Staudi14/tube-amplifier/Measurements/Tempreture spreading/VT_0004T.png

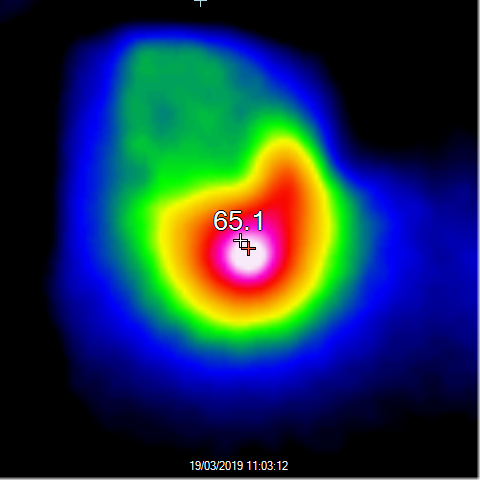
Measurements/Tempreture spreading/VT_0004T.png
