Staudi14/tube-amplifier/README.md

# tube-amplifier
2 - channel tube amplifier
