Staudi14/tube-amplifier/Präsentation/Staudenmayer_Schrefl_ProjektRöhrenverstärker.pptx

## Röhrenverstärker

Präsentation von Christian Schrefl und Patrik Staudenmayer

Christian Schrefl, Patrik Staudenmayer

## Inhaltsverzeichnis

- Projektbeschreibung
- Netzteil
  - Blockschaltbild
  - Transformator Grenzdaten
  - Tiefpass
  - Spannungsanpassung
  - Schaltplan des Netzteils
- Verstärker
  - Röhren kurz erklärt
  - Endstufe
  - Gesamtschaltung
  - Testaufbau
  - Messung
- Gehäuse

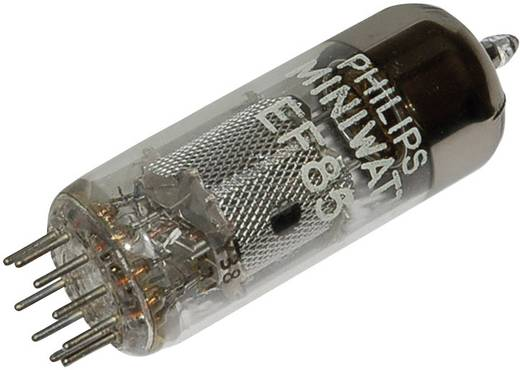
[picture p21: figure]

## Projektbeschreibung : Individuelle Themenstellungen

Patrik Staudenmayer | Adaption der üblichen Schaltkonzepte eines Netzteiles für Röhren, sowie Auswahl und Bestellung der Bauteile, Leiterplattenentwicklung für das Netzteils, sowie Berechnung der Ausgangsüberträger.
Christian Schrefl | Adaption der üblichen Schaltkonzepte der verstärkenden Elemente, sowie Auswahl und Bestellung der Bauteile, Aufbau der verstärkenden Elemente.

## Projektbeschreibung : Geplantes Ergebnis

Patrik Staudenmayer | Das Netzteil soll stabil die Versorgungsspannungen liefern.
Christian Schrefl | Die Verstärkenden Elemente sollen stabil ein Eingangssignal mit 6W ausgeben.

## Projektbeschreibung : Meilensteine

- 27.11.2018 Entwicklung des Schaltungskonzepts abgeschlossen, benötigte Bauteile bestellt
- 15.01.2019 Prototyp der Verstärkerschaltung (1 Kanal) fertiggestellt
- 26.02.2019 Leiterplattenentwicklung abgeschlossen
- 30.04.2019 Finale Version des Netzteils und eines Kanales
- 28.05.2019 Gesamttests abgeschlossen

## Netzteil : Blockschaltbild


280V DC

280V DC

## Netzteil : Transformator Grenzdaten

| Primärseite | Sekundärseite
Spannungen | 230 V_(RMS) | 250 V_(peak)
| | 6,3 V_(RMS)
Ströme | (104mA∗250V+1,6A∗6,3V)/(230V)=0,157A an der 230 V_(RMS) Wicklung | 2∗(50 mA+2mA)=104mA an der 250 V_(peak) Wicklung
| | 2^1 ∗(0,76A^2 +0,3A^3 )=1,6A an der 6,3 V_(RMS) Wicklung

[1] Es wird der doppelte Strom benötigt, da zwei Röhren für einen Stereoverstärker benötigt werden.
[2] Ströme für die Endstufenröhre EL84
[3] Ströme für die Vorverstärkerröhre 12AX7

## Netzteil : Transformator Grenzdaten

- Verwendeter Trafo: TRA400 von die-wuesten.de
- 200VA Trafo

Primärseite | Sekundärseite
100V | 2 * 270 V_(eff) 200mA
127V | 2 * 5 0V_(eff) 200mA
230V | 5 V_(eff) 3,5A
| 6,3V 2A
| 6,3V 7A

## Netzteil : Tiefpass

- Grenzfrequenz f_g <100Hz , da:


## Netzteil : Tiefpass

## Netzteil : Tiefpass

## Netzteil : Spannungsanpassung

- Trafo transformiert Eingangsspannung auf eine zu hohe Ausgangsspannung -> Spannungsteiler
R_1 =(70V)/((280V)/(2,5k))=625Ω
- Realisierung von R_1 :

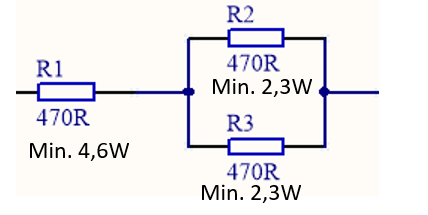
[picture p22: figure]
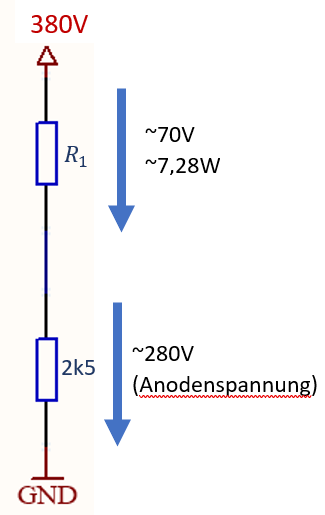
[picture p23: figure]

## Netzteil : Schaltplan

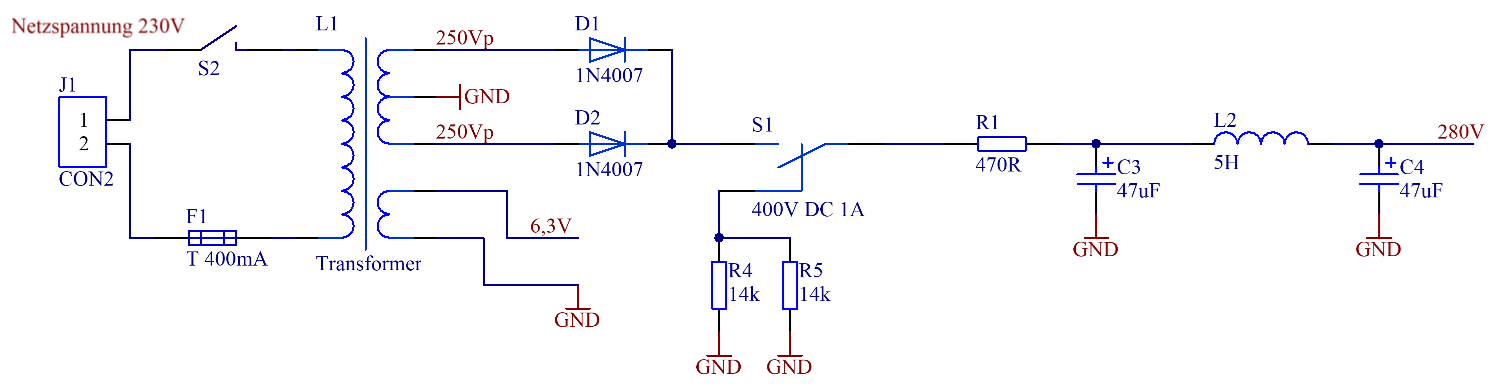
[picture p24: figure]

## Verstärker : Röhren kurz erklärt

- Was sind Elektronenröhren:

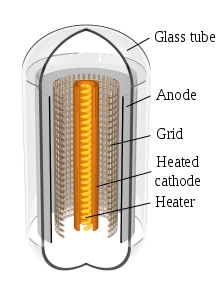
[picture p25: figure]
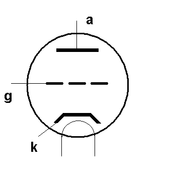
[picture p26: figure]

## Verstärker: Endstufe

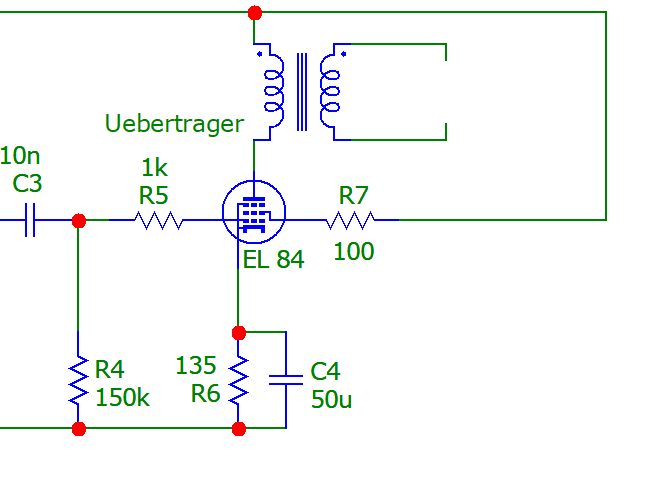
[picture p27: figure]

5,2k Ohm

8 Ohm Ausgang

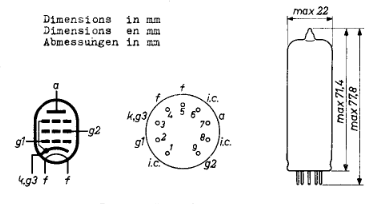
[picture p28: figure]

EL 84 Pin-out

+

## Verstärker: Gesamtschaltung

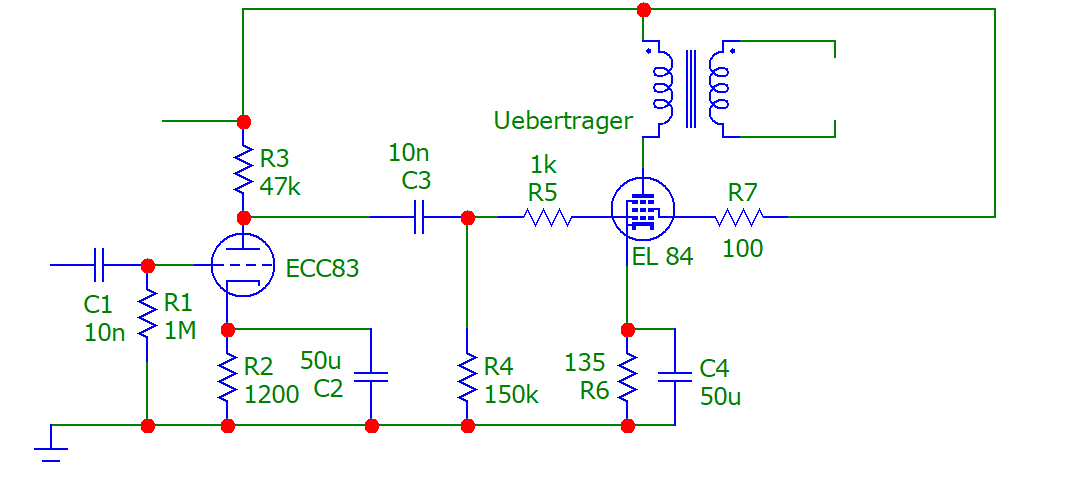
[picture p29: figure]

280V DC in

Out

Signal in

+

+

## Verstärker: Testaufbau

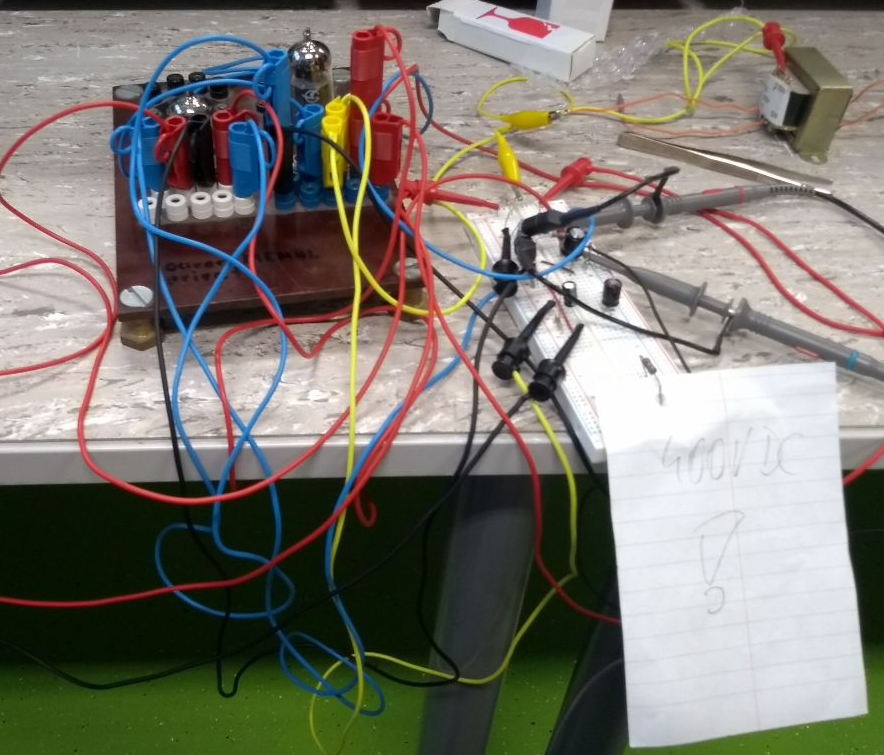
[picture p30: figure]
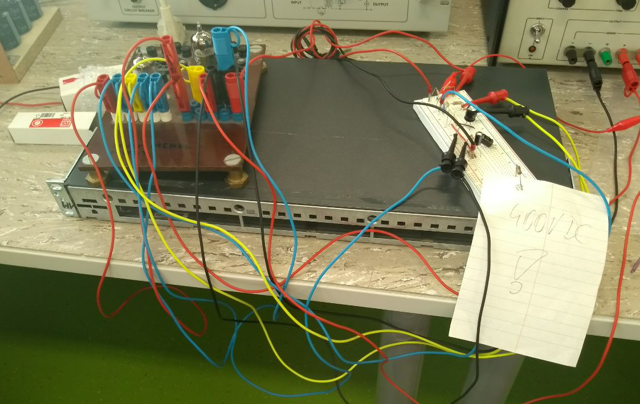
[picture p31: figure]

## Slide 18

Verstärker: Messungen

Bode Diagram linker Kanal

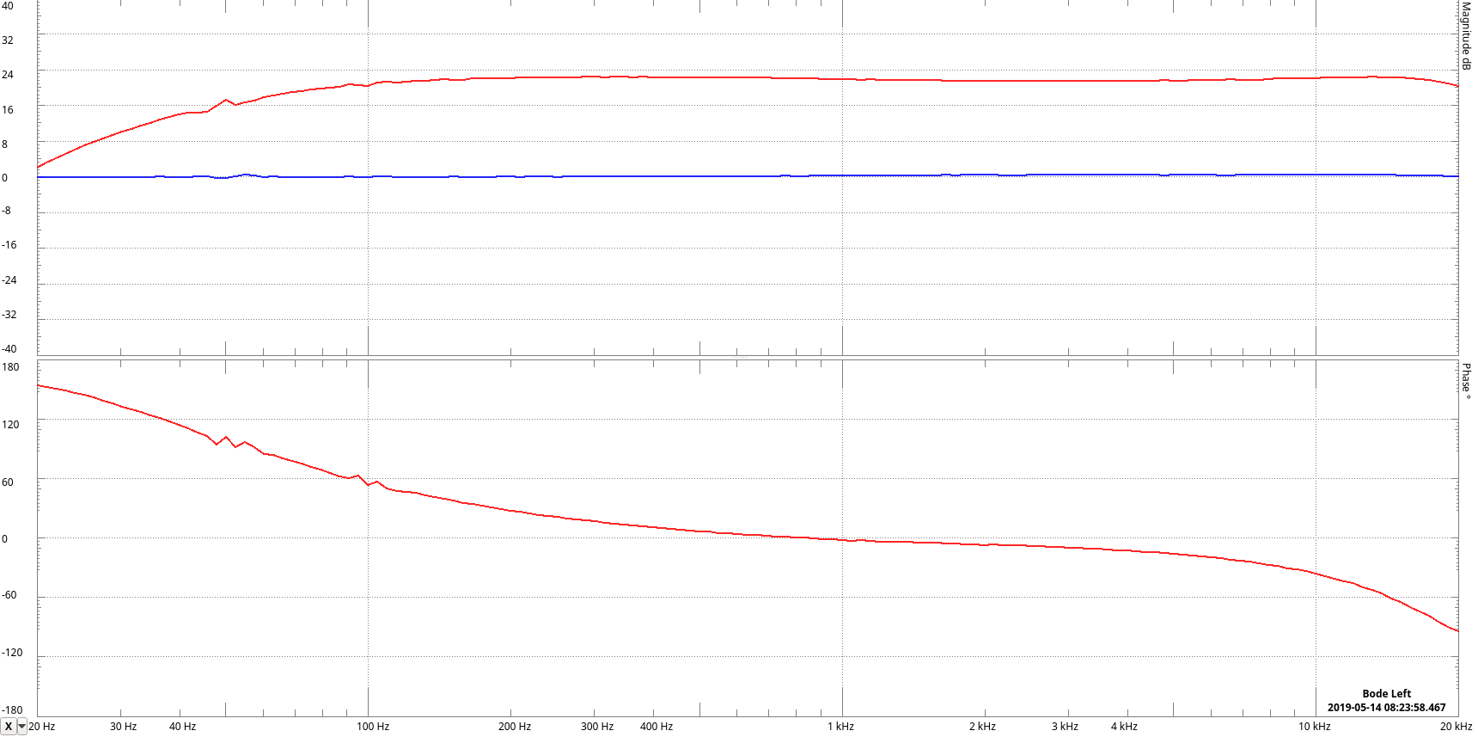
[picture p32: figure]

Christian Schrefl, Patrik Staudenmayer

## Slide 19

Verstärker: Messungen

Bode Diagram rechter Kanal

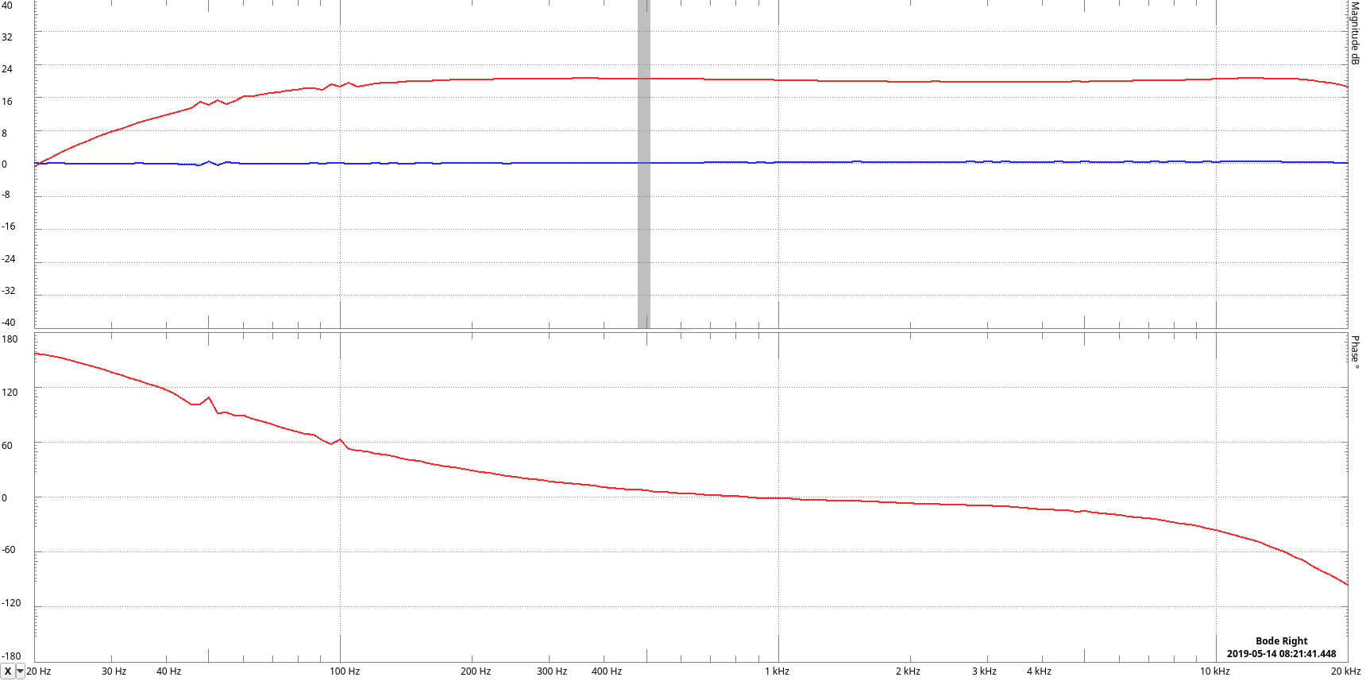
[picture p33: figure]

Christian Schrefl, Patrik Staudenmayer

## Gehäuse

- Alle Spulen zueinander verdreht
- Möglichst viel Abstand zwischen Verstärkenden Elementen und Netzteil
