Staudi14/tube-amplifier/Ideensammlung.docx

5 Kanal Röhrenverstärker

5 Kanal Röhrenverstärker für 5.0 Sound Anlage

Ziele:

- 5 x 6W
- Netzteil für Anodenspannung
- Netzteil für Übrige Beschaltung ?
- Ausgangswiderstand 4-8Ω
- Gehäuse
