Staudi14/tube-amplifier/Bestelliste/Ausgangsübertrager.PNG

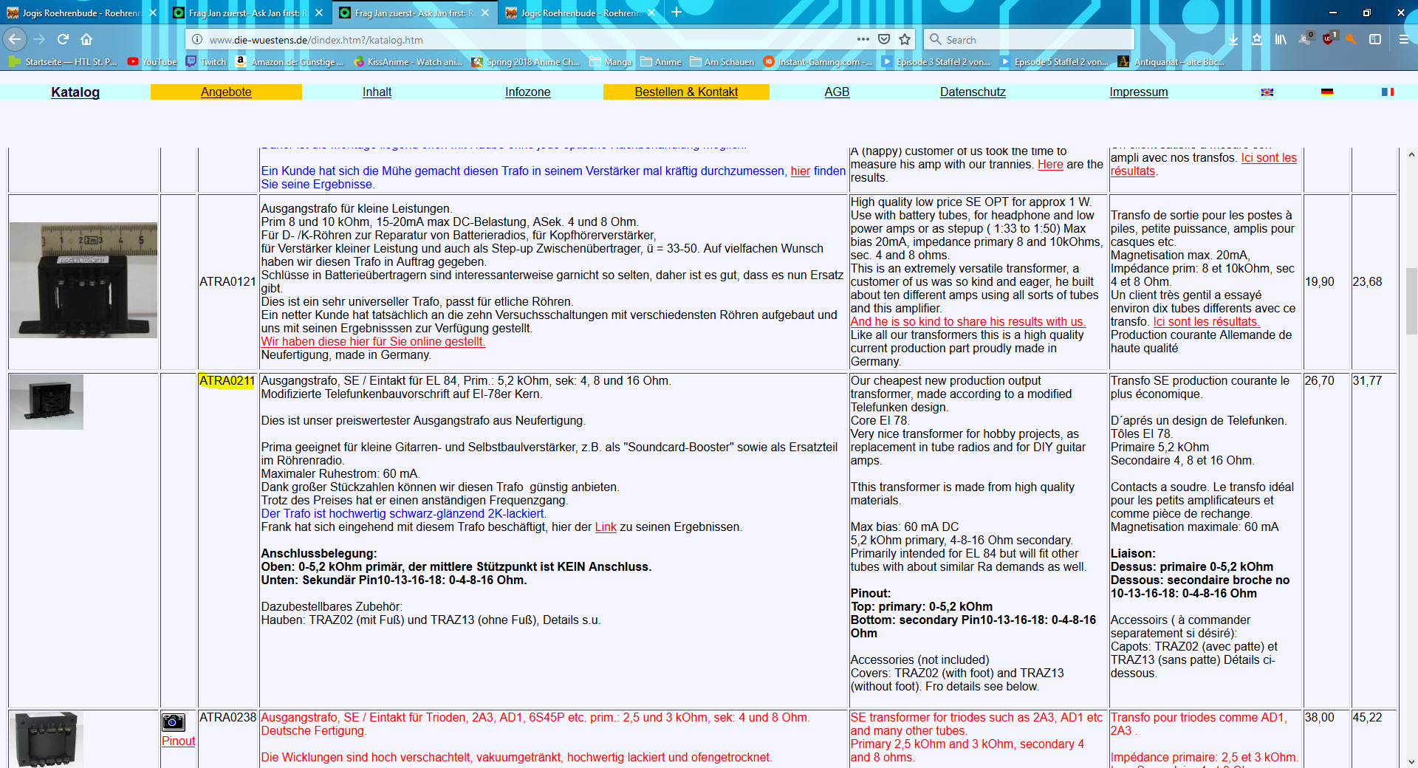
Bestelliste/Ausgangsübertrager.PNG
