Staudi14/tube-amplifier/Bestelliste/Netzdrossel.PNG

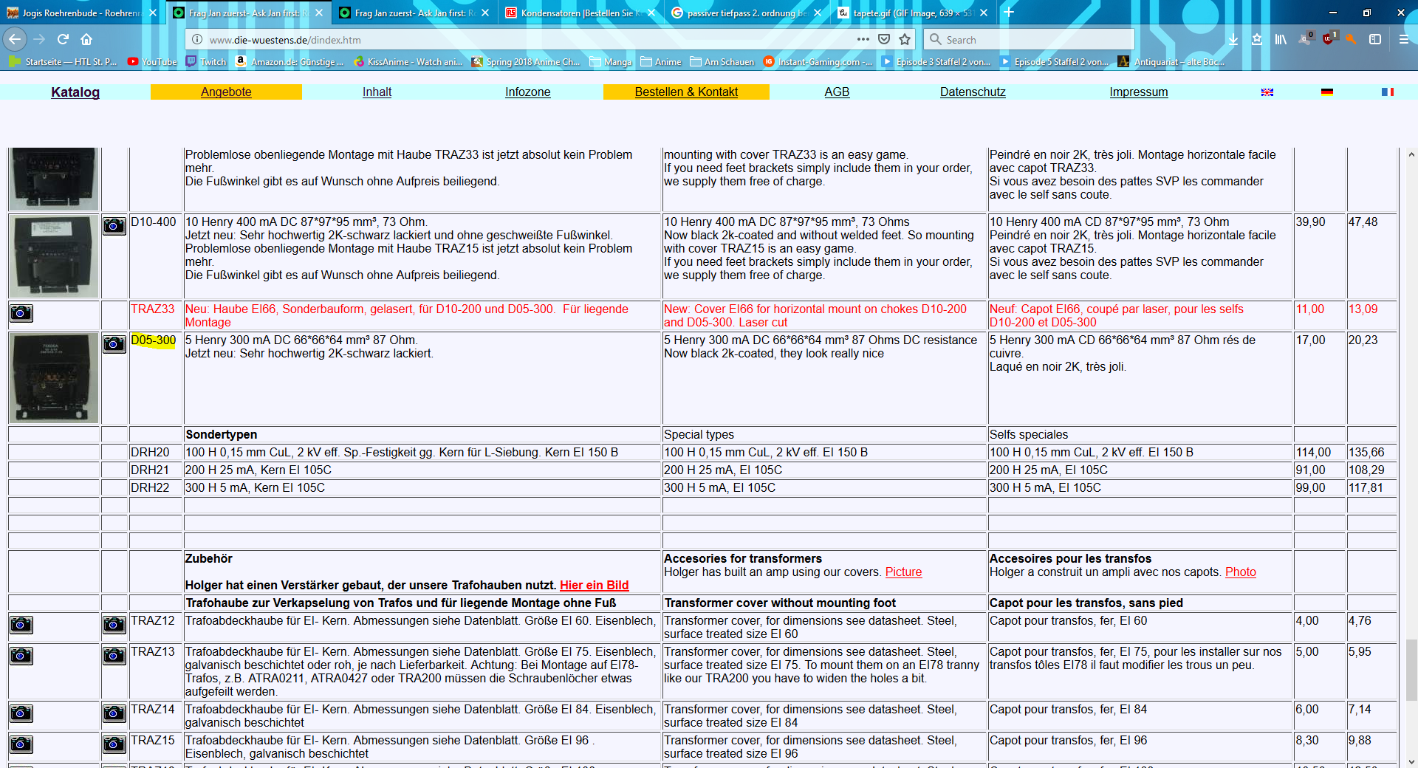
Bestelliste/Netzdrossel.PNG
