Staudi14/tube-amplifier/Bestelliste/Trafo.PNG

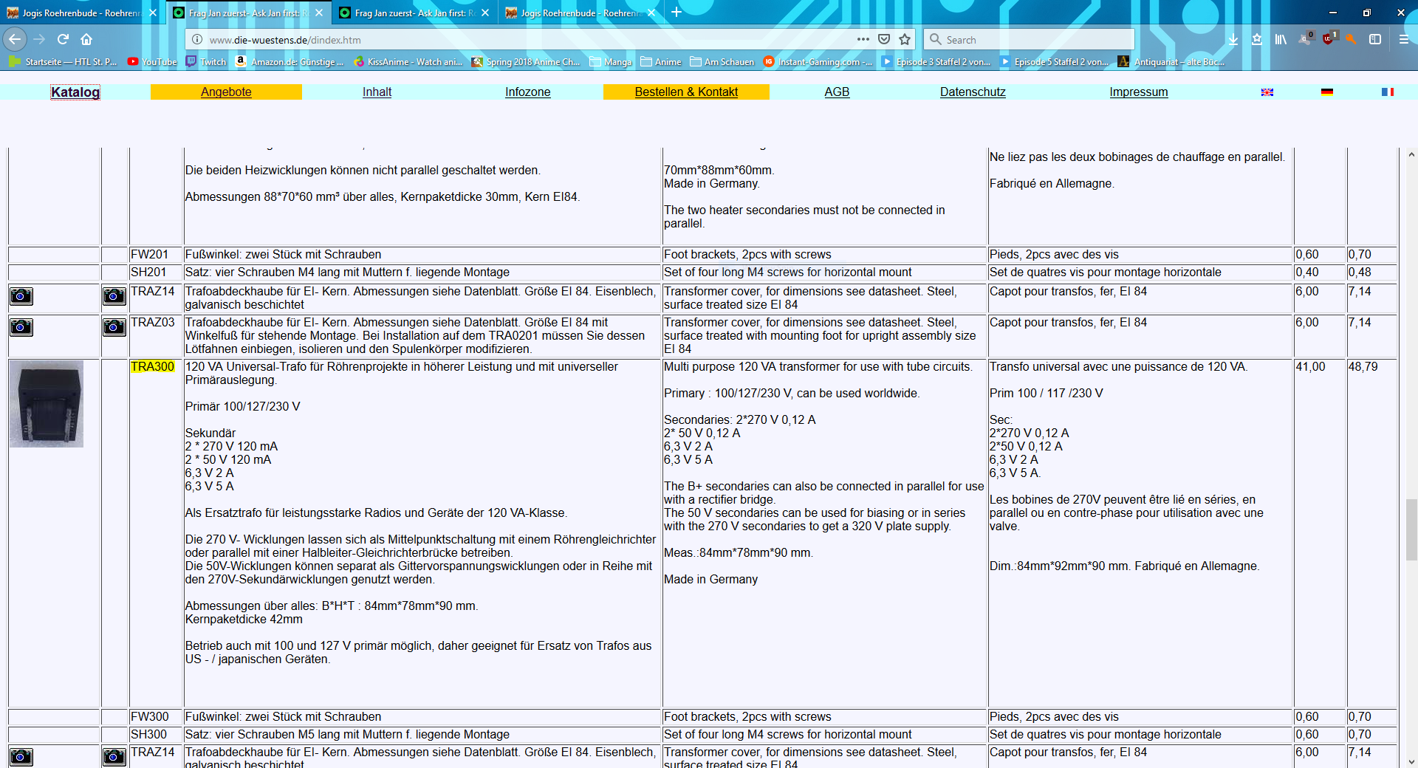
Bestelliste/Trafo.PNG
