Staudi14/tube-amplifier/Gehaeuse/Gehaeuse_Deckel-1.png

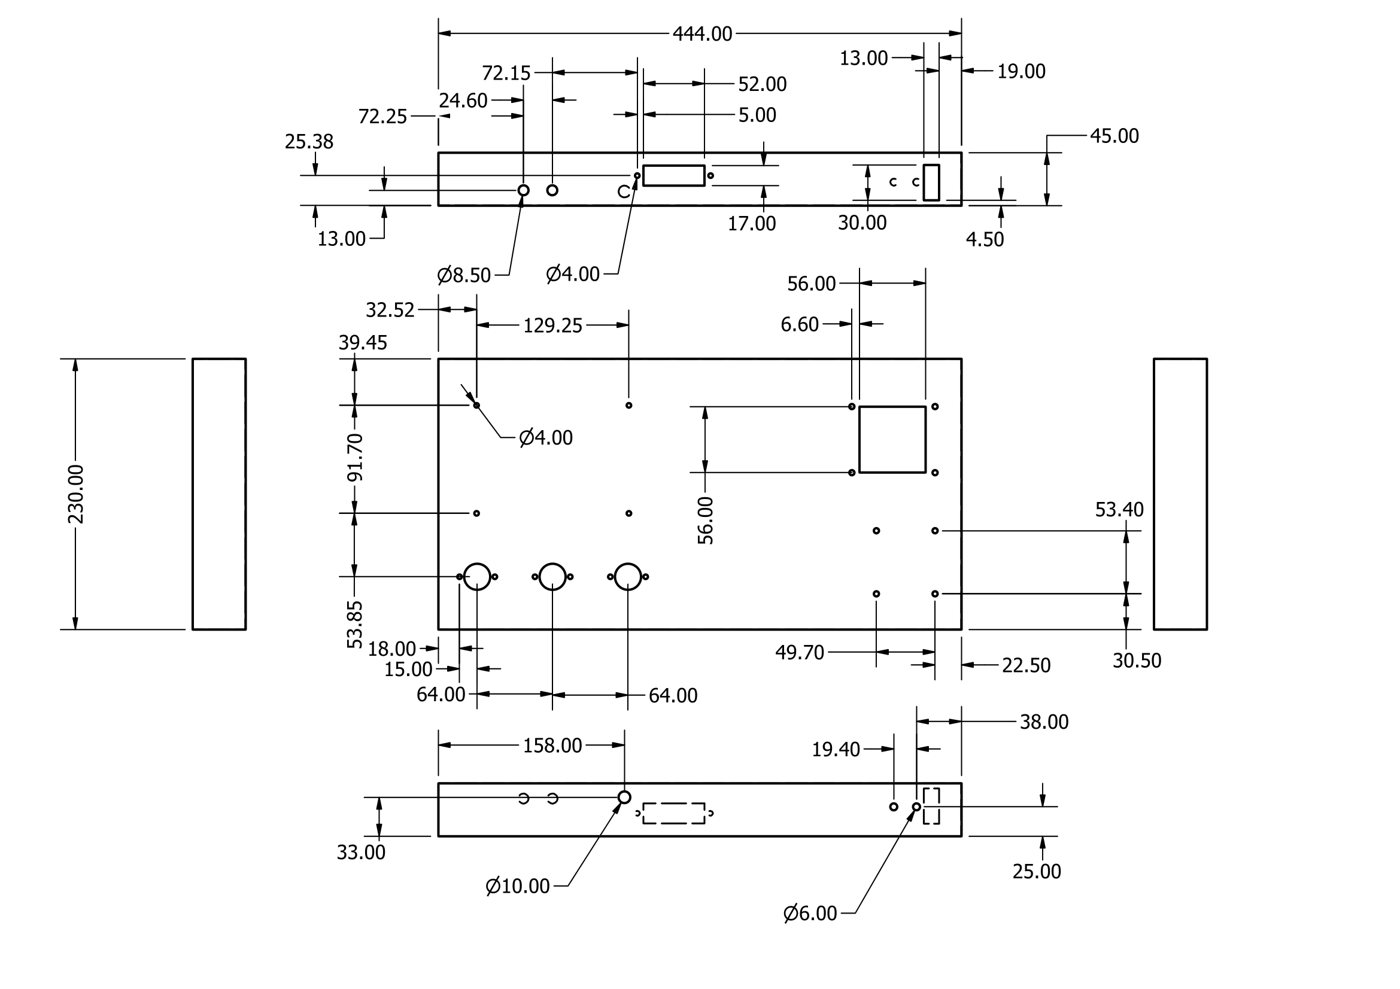
Gehaeuse/Gehaeuse_Deckel-1.png
