Staudi14/tube-amplifier/(list of files, cad)

Other CAD files:
Gehaeuse/Gehaeuse_Deckel.dwg
Gehaeuse/OldVersions/Gehaeuse_Deckel.0000.dwg
Gehaeuse/OldVersions/Gehaeuse_Deckel.0001.dwg
Gehaeuse/Gehaeuse_Deckel.ipt
Gehaeuse/OldVersions/Gehaeuse_Deckel.0011.ipt
