Staudi14/tube-amplifier/Measurements/Bode_Full.csv

Frequency (Hz) | Channel 2 Magnitude (dB) | Channel 2 Phase (°)
20 | -27.609554809618938 | 15.929451371303644
20.185243819740947 | -27.404829168923243 | 15.459493041847756
20.372203403119507 | -27.117453394221322 | 15.162586536047026
20.560894641866195 | -27.095344961004404 | 16.008301263267562
20.751333574903718 | -26.741915419935061 | 15.523338533334313
20.943536389710406 | -26.530944036880072 | 15.8468582360045
21.13751942369608 | -26.53119728128604 | 14.757073651138802
21.333299165590773 | -26.230332509274366 | 14.212280454128788
21.530892256846318 | -26.198858114044754 | 14.278061058173554
21.730315493050767 | -25.934395849334283 | 14.10321601754114
21.931585825356198 | -25.671464961845523 | 13.704491366940626
22.13472036191947 | -25.470076076075088 | 13.354230234248277
22.339736369356451 | -25.237804859199329 | 13.260474473127189
22.546651274209744 | -25.266508951407864 | 13.153983774522038
22.755482664429827 | -24.973872454523267 | 12.253375745905737
22.966248290870222 | -24.843293504313326 | 12.241395769052122
23.17896606879621 | -24.609501812396253 | 11.160383722100294
23.393654079407693 | -24.421164408995818 | 12.132719261717583
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
