Staudi14/tube-amplifier/Measurements/Inputamplifier.csv

x-axis | 1 | 2
second | Volt | Volt
-2.500000E-03 | +28.643213E-03 | -502.512515E-03
-2.497500E-03 | +34.673364E-03 | -582.914524E-03
-2.495000E-03 | +32.663314E-03 | -582.914524E-03
-2.492500E-03 | +28.643213E-03 | -502.512515E-03
-2.490000E-03 | +28.643213E-03 | -502.512515E-03
-2.487500E-03 | +28.643213E-03 | -422.110505E-03
-2.485000E-03 | +32.663314E-03 | -502.512515E-03
-2.482500E-03 | +28.643213E-03 | -422.110505E-03
-2.480000E-03 | +28.643213E-03 | -422.110505E-03
-2.477500E-03 | +28.643213E-03 | -341.708496E-03
-2.475000E-03 | +26.633163E-03 | -341.708496E-03
-2.472500E-03 | +26.633163E-03 | -341.708496E-03
-2.470000E-03 | +22.613063E-03 | -261.306487E-03
-2.467500E-03 | +22.613063E-03 | -261.306487E-03
-2.465000E-03 | +24.623113E-03 | -261.306487E-03
-2.462500E-03 | +22.613063E-03 | -180.904478E-03
-2.460000E-03 | +22.613063E-03 | -180.904478E-03
-2.457500E-03 | +18.592962E-03 | -100.502469E-03
-2.455000E-03 | +20.603012E-03 | -180.904478E-03
-2.452500E-03 | +20.603012E-03 | -100.502469E-03
-2.450000E-03 | +18.592962E-03 | -20.100459E-03
-2.447500E-03 | +14.572862E-03 | -20.100459E-03
-2.445000E-03 | +14.572862E-03 | +60.301550E-03
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
