Staudi14/tube-amplifier/Measurements/Left output.csv

#Digilent WaveForms Network Analyzer - Bode
#Device Name: Discovery2
#Serial Number: SN:210321A68A6E
#Date Time: 2019-03-26 10:03:55.723
#Start: 100 Hz
#Stop: 30000 Hz
#Steps: 151
#Wavegen: Wavegen1
#Amplification: 1 X
#Settle: 10 ms
#MinPeriods: 16
#Channel: Channel 2
#Range: 5.44304 V
#Offset: -1.08332e-05 V
#Relative: yes
#Wavegen Channel 1: Enabled
#Mode: Simple
#Type: Sine
#Frequency: 5 kHz
#Amplitude: 50 mV
#Offset: 0 V
#Symmetry: 50 %
#Phase: 0 °
#Wavegen Channel 2: Enabled
#Mode: Simple
#Type: Sine
#Frequency: 5 kHz
#Amplitude: 50 mV
#Offset: 0 V
#Symmetry: 50 %
#Phase: 0 °
Frequency (Hz) | Channel 2 Magnitude (dB) | Channel 2 Phase (°)
100 | 37.483 | 47.1673
103.876 | 37.3478 | 46.5331
107.902 | 37.4618 | 45.2117
112.084 | 37.6913 | 42.6198
116.428 | 37.7417 | 42.4512
120.94 | 37.8351 | 40.7507
125.628 | 37.9178 | 38.9991
130.497 | 38.0102 | 37.8028
135.554 | 38.0167 | 36.5881
140.808 | 38.1295 | 35.5902
146.265 | 38.2059 | 34.2108
151.934 | 38.228 | 33.1795
157.823 | 38.2462 | 31.596
163.94 | 38.3119 | 30.9734
170.293 | 38.3425 | 29.5195
176.894 | 38.4077 | 28.3815
183.75 | 38.4562 | 27.5559
190.871 | 38.49 | 26.62
198.269 | 38.5381 | 25.6133
205.953 | 38.5622 | 24.6646
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
