Staudi14/tube-amplifier/Measurements/Preamp.csv

#Digilent WaveForms Oscilloscope Acquisition
#Device Name: Discovery2
#Serial Number: SN:210321A68A76
#Date Time: 2019-03-19 09:03:45.091
#Sample rate: 4e+06Hz
#Samples: 8192
#Trigger: Source: Channel 2 Type: Edge Condition: Rising Level: 0 V Hyst.: Auto HoldOff: 0 s
#Channel 1: Range: 100 mV/div Offset: 300 mV
#Channel 2: Range: 2 V/div Offset: -4 V
#Wavegen Channel 1: Running
#Mode: Simple
#Type: Sine
#Frequency: 1 kHz
#Amplitude: 100 mV
#Offset: 0 V
#Symmetry: 50 %
#Phase: 0 °
Time (s) | Channel 1 (V) | Channel 2 (V)
-0.00102375 | 0.0171074 | -0.817156
-0.0010235 | 0.013811 | -0.803896
-0.00102325 | 0.013811 | -0.797266
-0.001023 | 0.013811 | -0.784006
-0.00102275 | 0.0171074 | -0.777376
-0.0010225 | 0.0171074 | -0.767432
-0.00102225 | 0.013811 | -0.760802
-0.001022 | 0.013811 | -0.757487
-0.00102175 | 0.013811 | -0.750857
-0.0010215 | 0.00721821 | -0.744227
-0.00102125 | 0.0105146 | -0.730967
-0.001021 | 0.0105146 | -0.714393
-0.00102075 | 0.0105146 | -0.697818
-0.0010205 | 0.0105146 | -0.694503
-0.00102025 | 0.00721821 | -0.681243
-0.00102 | 0.0105146 | -0.674613
-0.00101975 | 0.00721821 | -0.664669
-0.0010195 | 0.013811 | -0.661354
-0.00101925 | 0.013811 | -0.654724
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
