Staudi14/tube-amplifier/Measurements/Preamp_bode.csv

#Digilent WaveForms Network Analyzer - Bode
#Device Name: Discovery2
#Serial Number: SN:210321A68A76
#Date Time: 2019-03-19 09:13:46.624
#Start: 10 Hz
#Stop: 200000 Hz
#Steps: 151
#Wavegen: Wavegen1
#Amplification: 1 X
#Settle: 10 ms
#MinPeriods: 16
#Channel: Channel 1
#Range: 54.0084 V
#Offset: 0.00307853 V
#Relative: no
#Channel: Channel 2
#Range: 54.3119 V
#Offset: 0.00315965 V
#Relative: yes
Frequency (Hz) | Channel 1 Magnitude (dB) | Channel 2 Magnitude (dB) | Channel 2 Phase (°)
10 | 0.0170059 | 27.0257 | -100.161
10.6825 | 0.0336365 | 27.5097 | -102.506
11.4116 | 0.0210581 | 28.0086 | -104.803
12.1905 | 0.027551 | 28.4716 | -107.159
13.0225 | 0.0191447 | 28.9326 | -109.424
13.9113 | 0.027777 | 29.3615 | -111.78
14.8608 | 0.00175117 | 29.8062 | -114.201
15.875 | 0.022565 | 30.1869 | -116.514
16.9585 | 0.0217195 | 30.57 | -118.742
18.116 | 0.017376 | 30.9362 | -121.21
19.3524 | 0.0248722 | 31.2742 | -123.48
20.6733 | 0.0271715 | 31.5961 | -125.809
22.0842 | 0.00741973 | 31.9202 | -128.123
23.5915 | 0.0169384 | 32.1968 | -130.398
25.2017 | 0.0247875 | 32.4562 | -132.648
26.9217 | 0.0140341 | 32.7114 | -134.826
28.7592 | 0.0172974 | 32.9361 | -137.005
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
