Staudi14/tube-amplifier/Measurements/Bode_Full.png

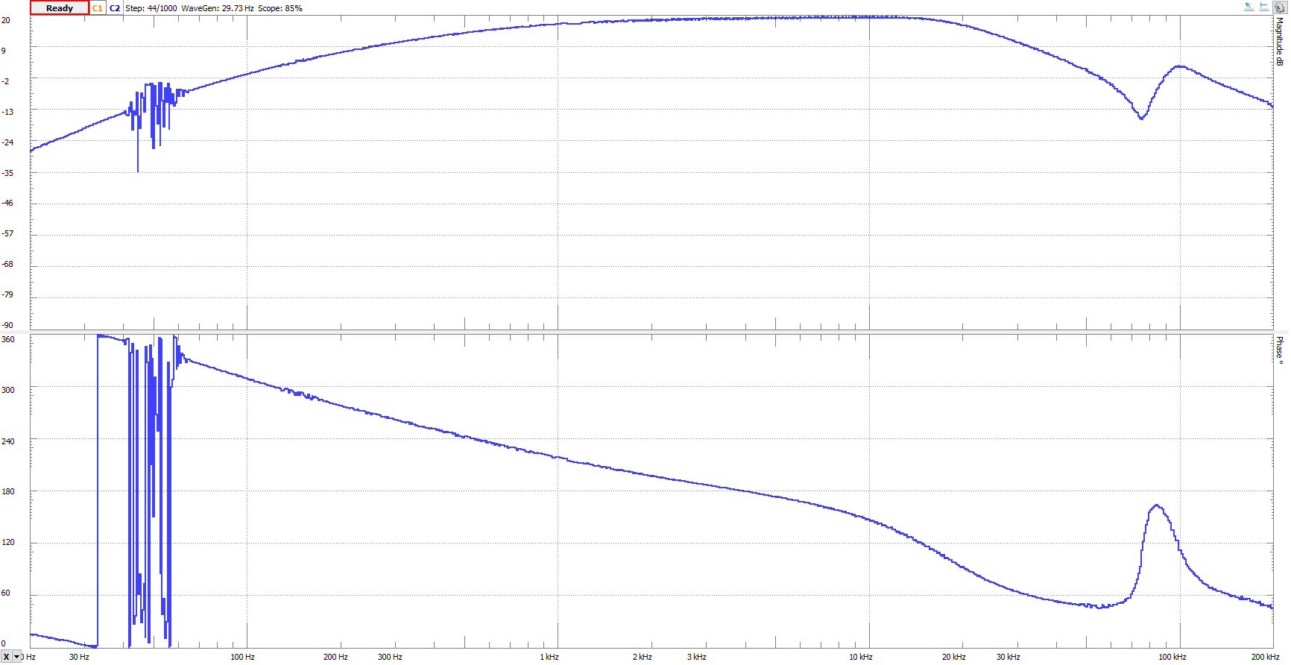
Measurements/Bode_Full.png
