Staudi14/tube-amplifier/Measurements/bode_left _full.png

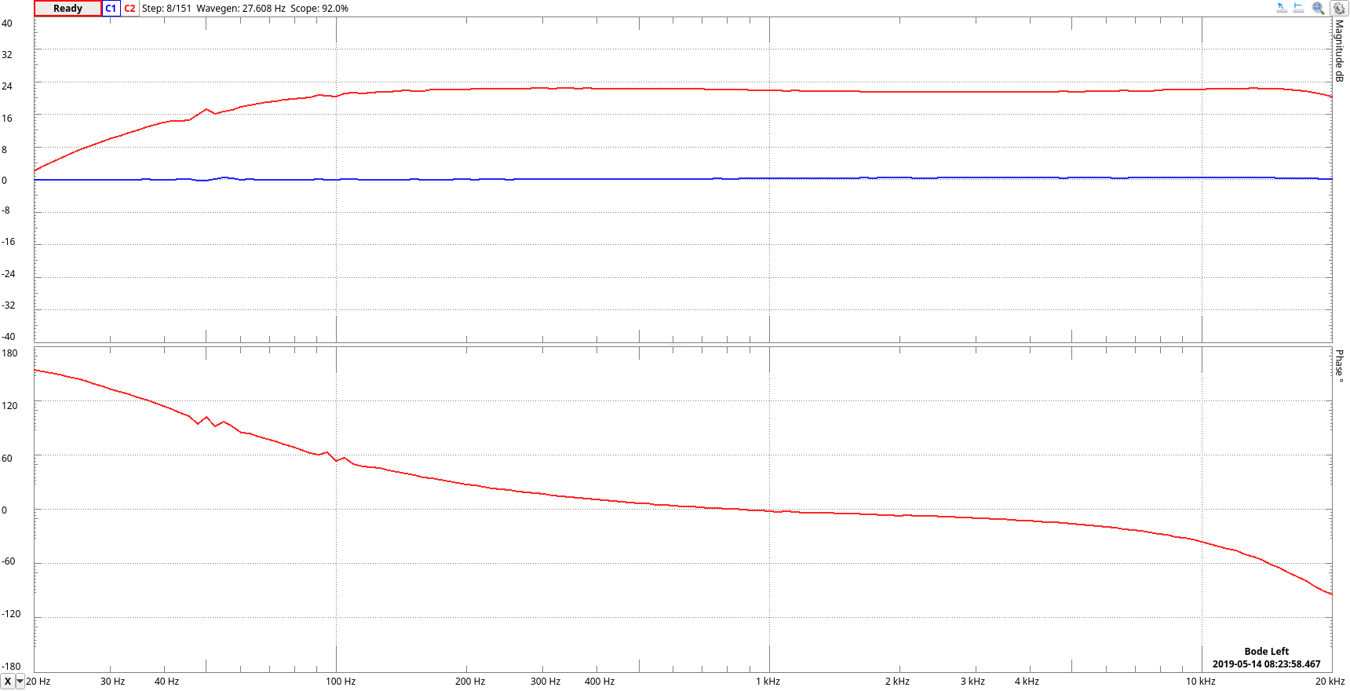
Measurements/bode_left _full.png
