Staudi14/tube-amplifier/Measurements/bode_right _full.png

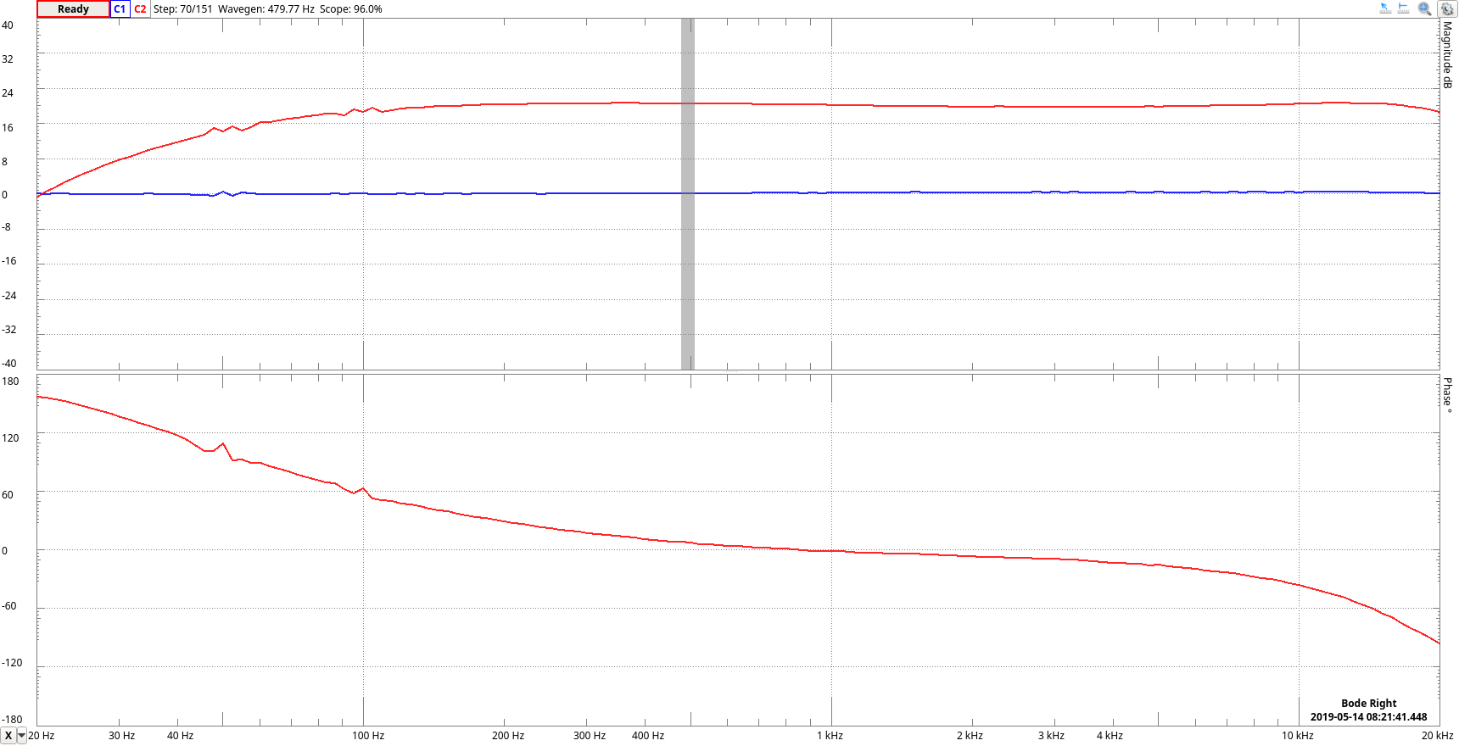
Measurements/bode_right _full.png
