Staudi14/tube-amplifier/Measurements/FallDelay.png

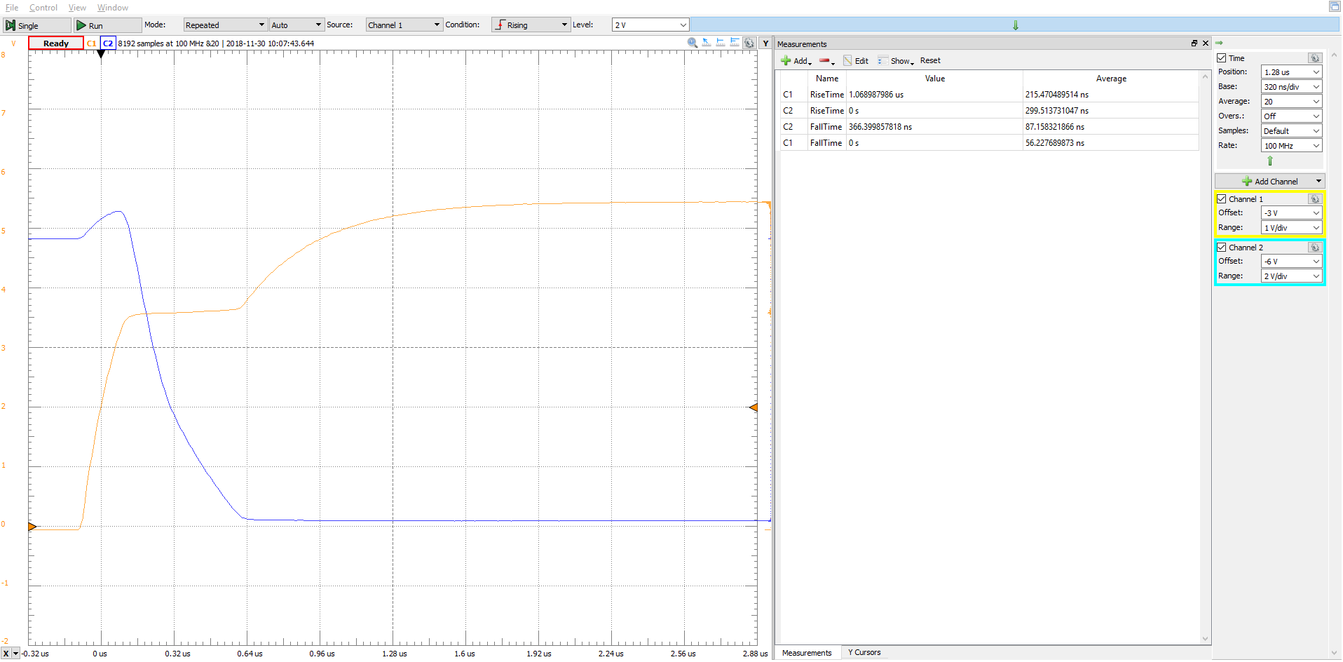
Measurements/FallDelay.png
