Staudi14/tube-amplifier/Measurements/Inputamplifier 50Hz modulation.png

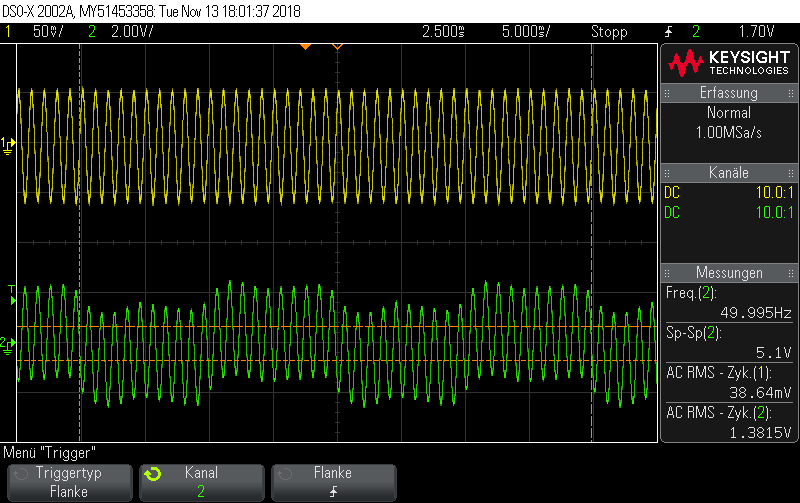
Measurements/Inputamplifier 50Hz modulation.png
