Staudi14/tube-amplifier/Measurements/Inputamplifier.png

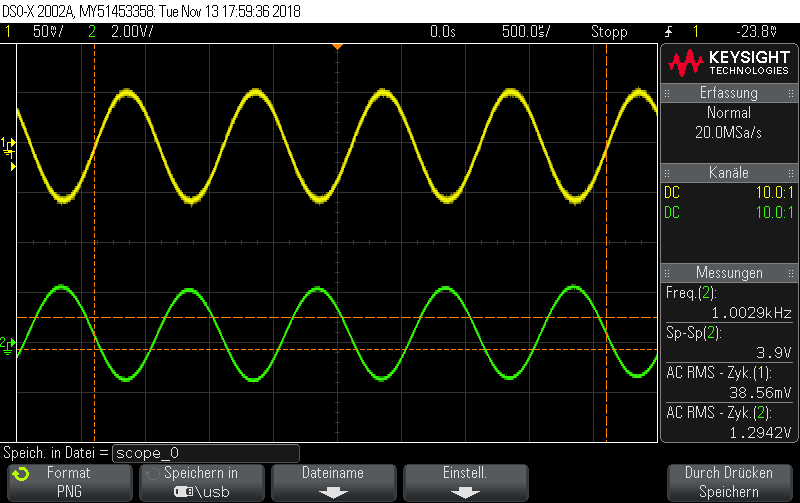
Measurements/Inputamplifier.png
