Staudi14/tube-amplifier/Measurements/Left output.png

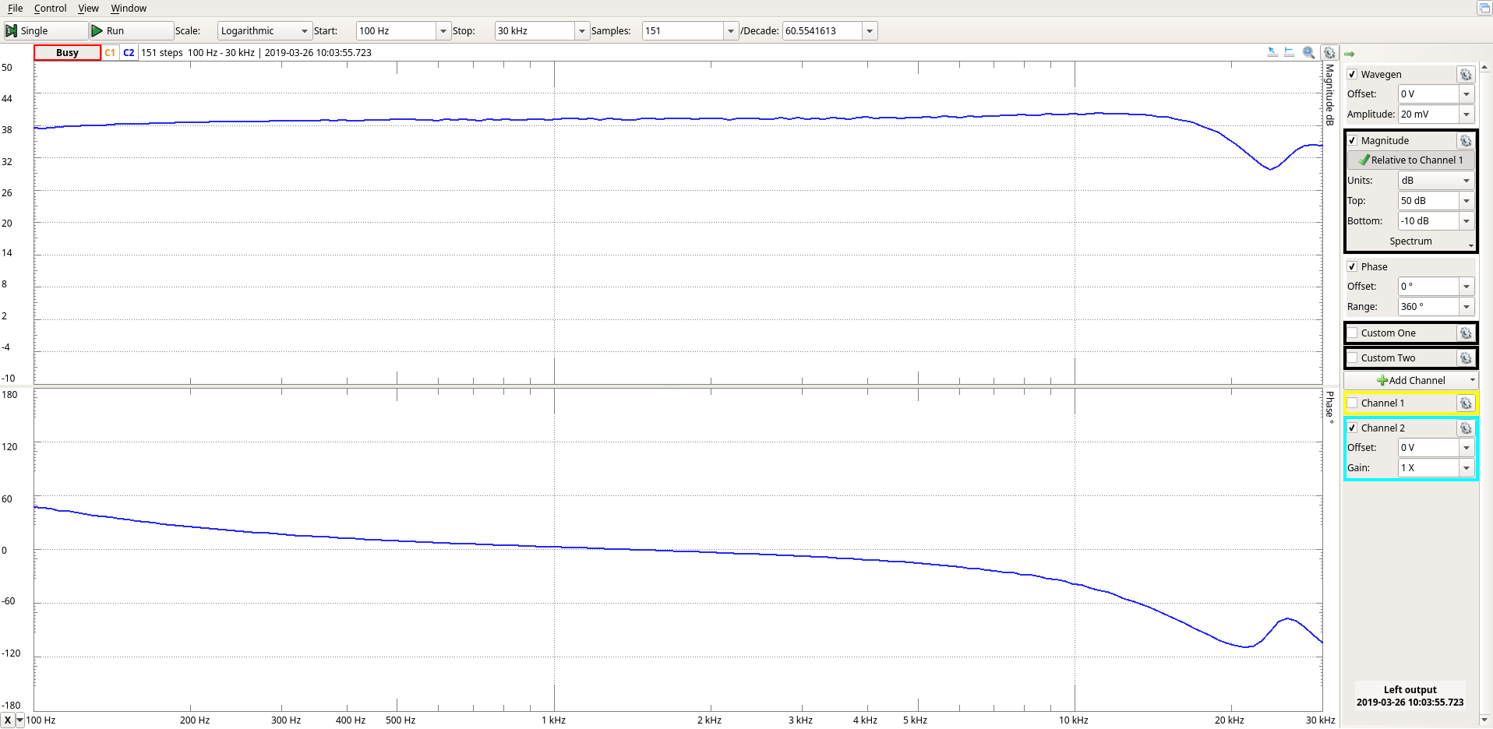
Measurements/Left output.png
