Staudi14/tube-amplifier/Measurements/Preamp.png

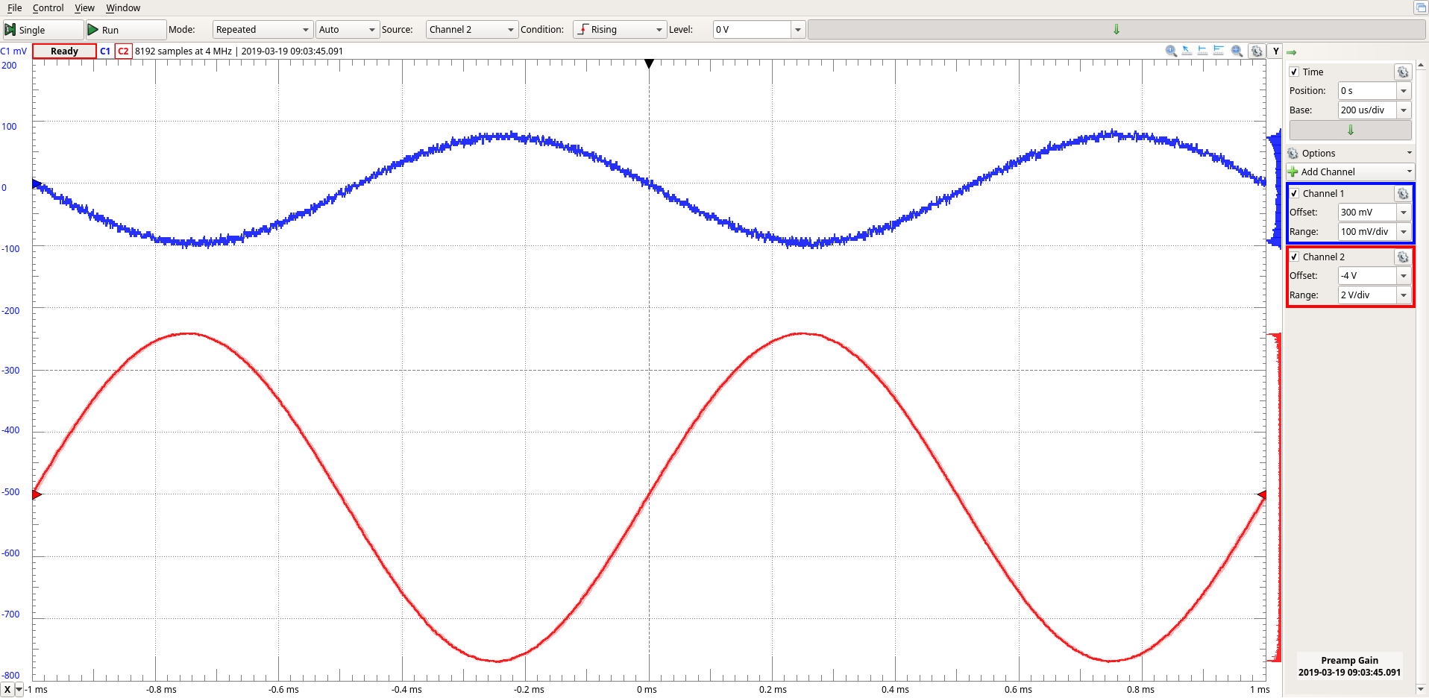
Measurements/Preamp.png
