Staudi14/tube-amplifier/Measurements/Preamp_bode.png

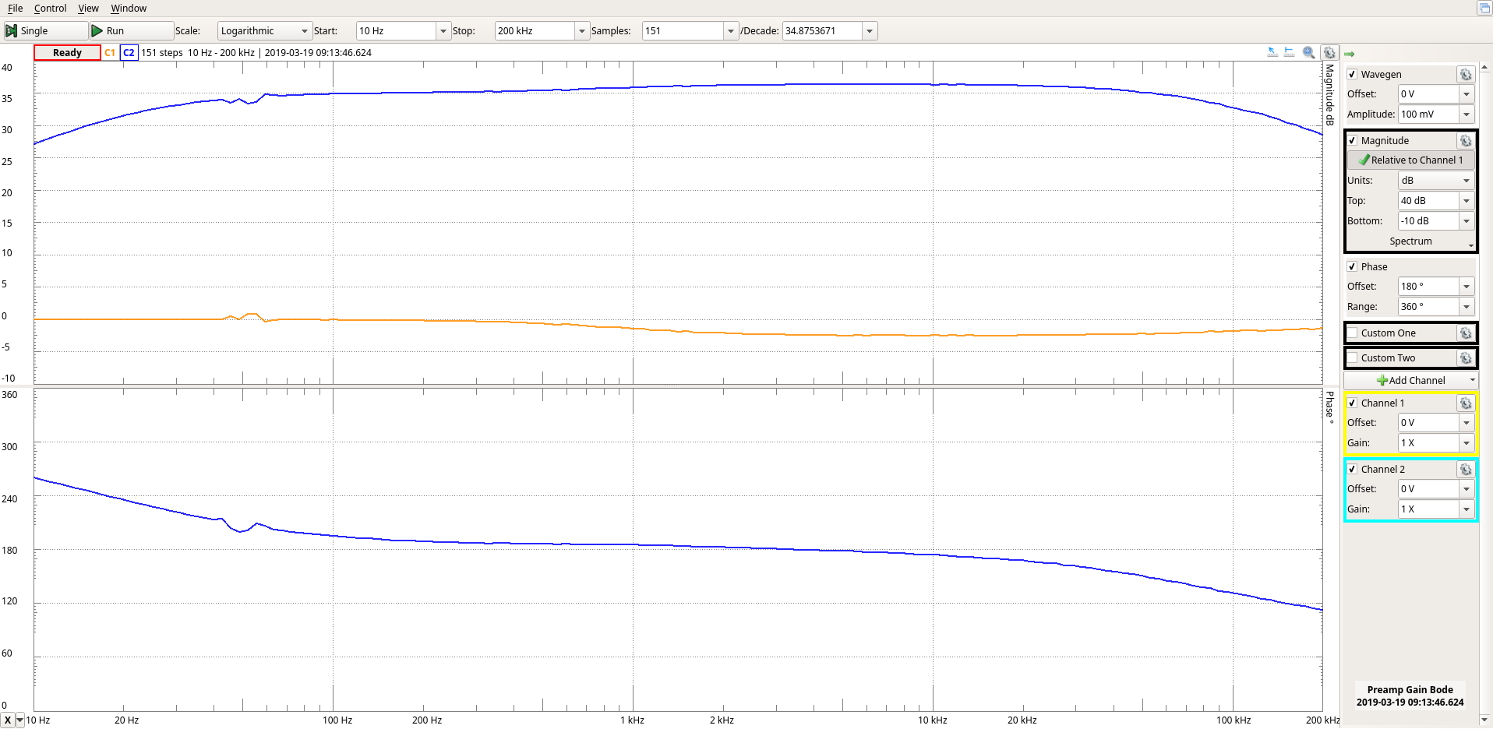
Measurements/Preamp_bode.png
