Staudi14/tube-amplifier/Measurements/Tempreture Messurement Voltag supply.jpg

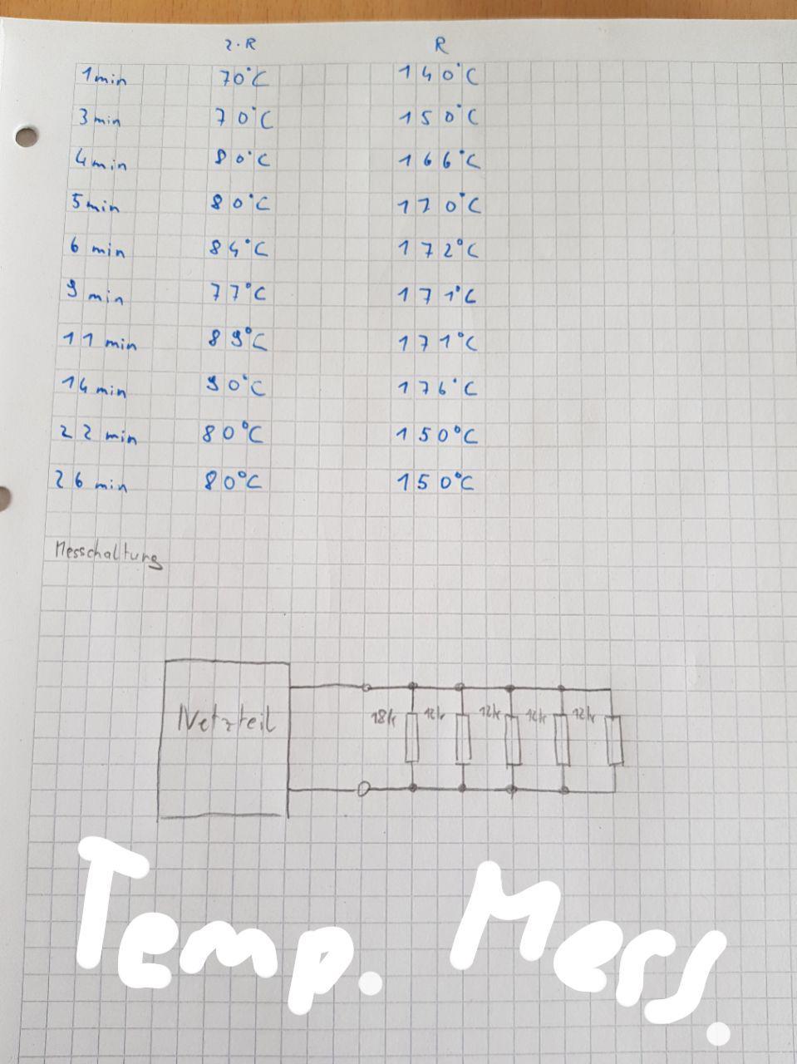
Measurements/Tempreture Messurement Voltag supply.jpg
