Staudi14/tube-amplifier/Measurements/Tempreture spreading/Temp IR/VT_0006T.png

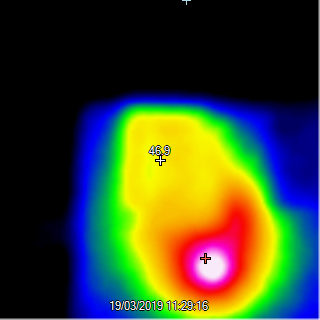
Measurements/Tempreture spreading/Temp IR/VT_0006T.png
