Staudi14/tube-amplifier/Measurements/Tempreture spreading/Temp visible/VT_0003T.png

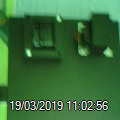
Measurements/Tempreture spreading/Temp visible/VT_0003T.png
