Staudi14/tube-amplifier/Measurements/Tempreture spreading/Temp visible/VT_0004T.png

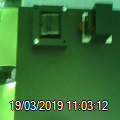
Measurements/Tempreture spreading/Temp visible/VT_0004T.png
