Staudi14/tube-amplifier/Measurements/Tempreture spreading/Temp visible/VT_0005T.png

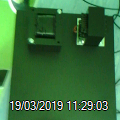
Measurements/Tempreture spreading/Temp visible/VT_0005T.png
