Staudi14/tube-amplifier/Measurements/Tempreture spreading/Temp visible/VT_0006T.png

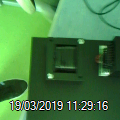
Measurements/Tempreture spreading/Temp visible/VT_0006T.png
