Staudi14/tube-amplifier/Measurements/Tempreture spreading/VT_0003T.png

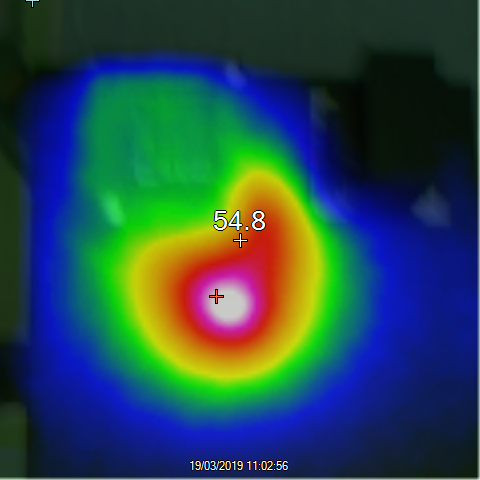
Measurements/Tempreture spreading/VT_0003T.png
