Staudi14/tube-amplifier/Gehaeuse/Gehaeuse_Deckel.pdf

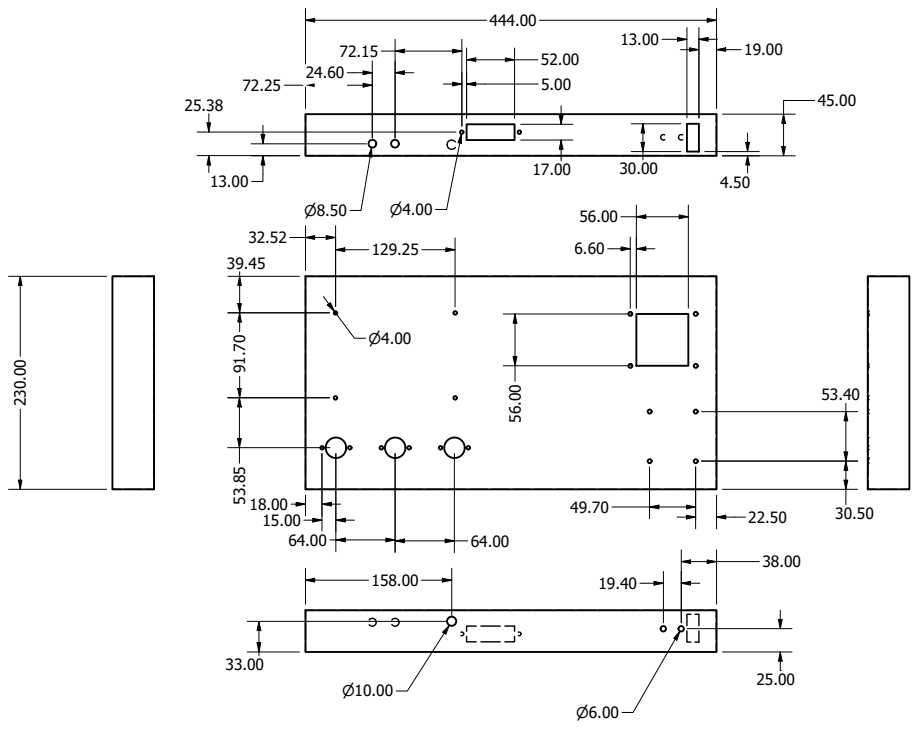
[picture p61: page 1]
