Staudi14/tube-amplifier/(list of files, drawings)

Other design files:
Shematic/Röhrenverstärker/Netzteil.SchDoc
Shematic/Röhrenverstärker/Röhrenverstärker.PrjPcb
Shematic/Röhrenverstärker/Spannugsteiler.SchDoc
Shematic/Röhrenverstärker/Tiefpassfilter Simulation.SchDoc
