Staudi14/tube-amplifier/(commit log)

2018-10-31 Added Block diagramm power supply
2018-11-18 Added Projektdokumentation :poop:
    Doku zu Ideensammlung umbenannt
    Angefangen ein Grundgerüst für die Dokumentation zu erstellen
2018-11-18 measurements and bericht
    [Inputamplifier.csv]
2018-11-18 Abendessen und Zwischenspeichern
    [Netzteil.SchDoc, PHASE(v_out).csv, Röhrenverstärker.PrjPcb, Röhrenverstärker.sdf, Tiefpassfilter Simulation.SchDoc, dB(v_out).csv]
2018-11-18 Doku auf Stand 18/11/2018 gebracht
    Projekt Doku auf den Stand von 18/11/2018 für gebracht, aber nur für den Netzteil abschnitt
    [Bodediagramm.xlsx, Röhrenverstärker.PrjPcb, Tiefpassfilter Simulation.SchDoc, dB(v_out).csv]
2018-11-30 Added some Measurements
    [Bode_Full.csv]
2019-01-06 An Präsentation gearbeitet
    [Netzteil.SchDoc, Spannugsteiler.SchDoc]
2019-01-15 Added start of mechanical drawing
    [Gehaeuse_Deckel.0002.ipt, Gehaeuse_Deckel.ipt]
2019-01-15 Worked on mechanical drawing
    [Gehaeuse_Deckel.0002.ipt, Gehaeuse_Deckel.0004.ipt, Gehaeuse_Deckel.ipt]
2019-01-15 Finished base drawing of the case
    [Gehaeuse_Deckel.0004.ipt, Gehaeuse_Deckel.0006.ipt, Gehaeuse_Deckel.ipt]
2019-02-12 Worked on mechanical drawing and wrote on "Arbeitsbericht_Staudenmayer"
    [Gehaeuse_Deckel.0006.ipt, Gehaeuse_Deckel.0008.ipt, Gehaeuse_Deckel.0009.ipt, Gehaeuse_Deckel.ipt]
2019-03-12 Create Tempreture Messurement Voltag supply.jpg
2019-03-19 Added temperature spreading measurements
2019-05-14 Added Measurements
    [Left output.csv, Preamp.csv, Preamp_bode.csv]
2019-05-14 Worked on documentation
    +Added toggle switch for anode voltage
    +Added mains switch
    [Bode.csv, Gehaeuse_Deckel.0008.ipt, Gehaeuse_Deckel.0009.ipt, Gehaeuse_Deckel.0010.ipt, Gehaeuse_Deckel.ipt, Netzteil.SchDoc, Röhrenverstärker.PrjPcb, Spannugsteiler.SchDoc]
2019-05-20 +Update Drew on case plan
    [Gehaeuse_Deckel.0001.dwg, Gehaeuse_Deckel.dwg, Netzteil.SchDoc]
2019-05-20 +Add Mechanical drawing to präsentation :gear:
    [Gehaeuse_Deckel.0000.dwg, Gehaeuse_Deckel.0010.ipt, Gehaeuse_Deckel.0011.ipt, Gehaeuse_Deckel.dwg, Gehaeuse_Deckel.ipt]
2019-05-21 +update shematic
    [Netzteil.SchDoc]
